SugarFootPedals/AudioScope/AudiOscope_front.JPG

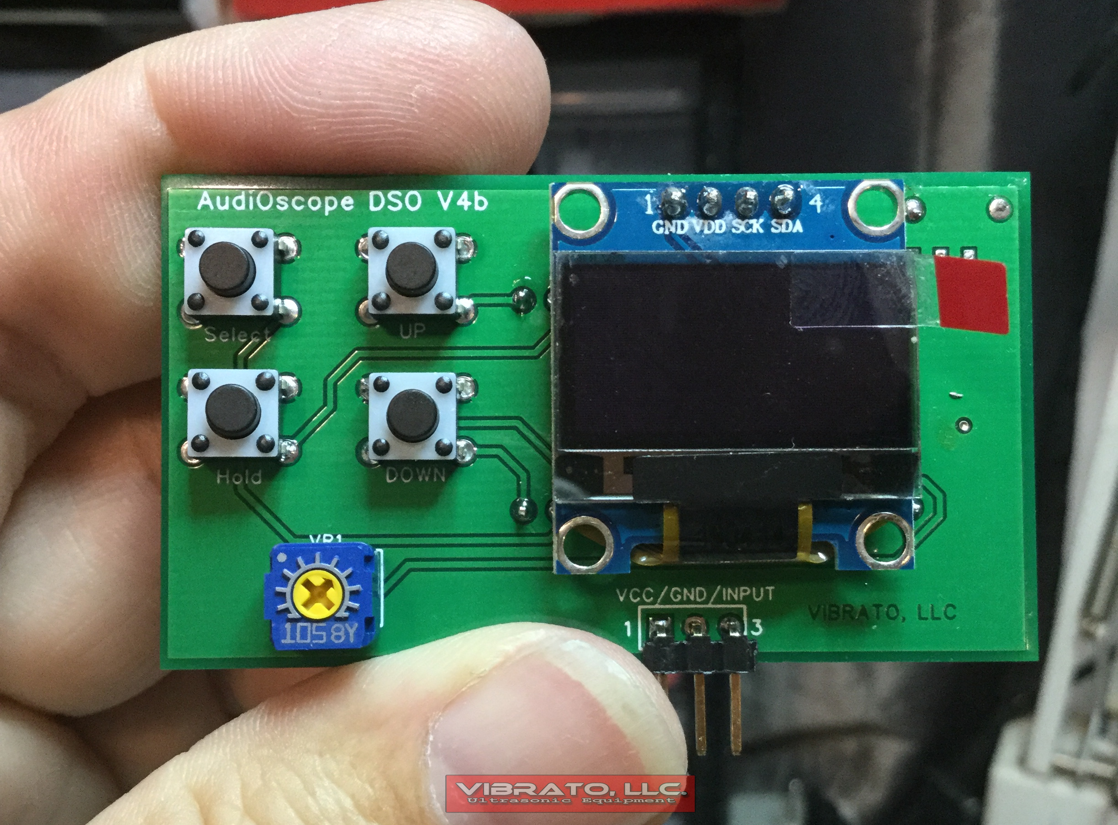
AudiOscope_front.JPG
