SugarFootPedals/AudioScope/AudiOscope Noise.JPG

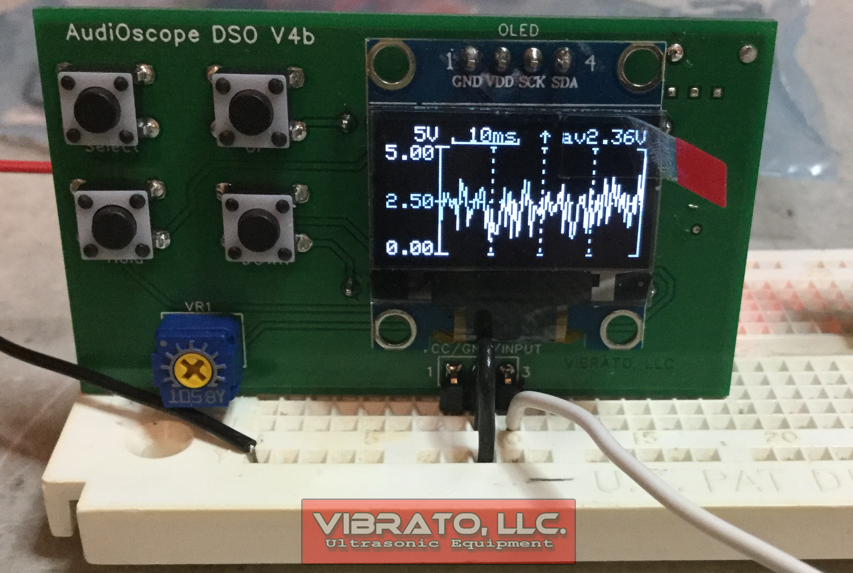
AudiOscope Noise.JPG
