SugarFootPedals/AudioScope/README.txt

A bread-boardable open-source Digital Storage Oscilloscope perfect for viewing audio signals while building sound circuits.

Based on this project by RadioPench : http://radiopench.blog96.fc2.com/blog-entry-893.html

Uses a generic Arduino-compatible ProMini and low count surface-mount devices (smd's).

Original and New Schematic, Working Arduino Code, gerber files included.
