SugarFootPedals/AudioScope/AudiOscope Boot.JPG

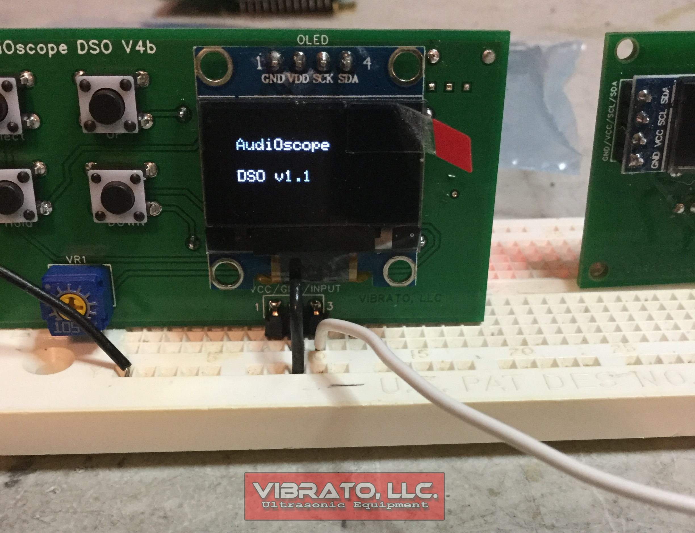
AudiOscope Boot.JPG
