SugarFootPedals/AudioScope/AudiOscope Chainsaw.JPG

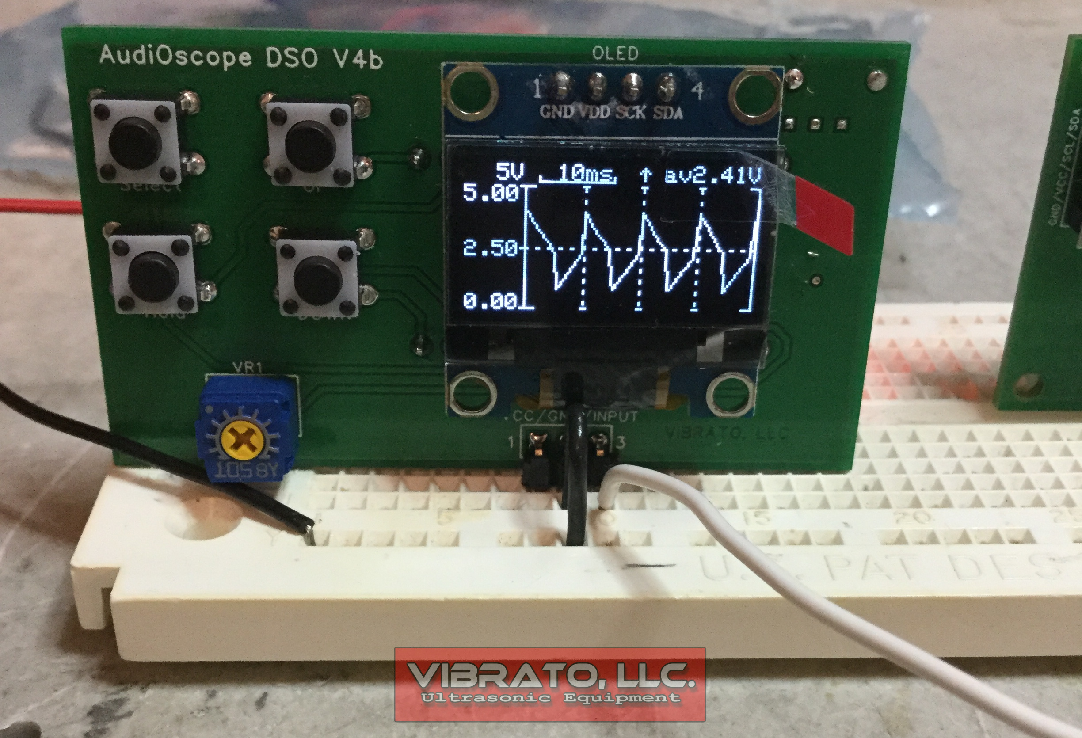
AudiOscope Chainsaw.JPG
