SugarFootPedals/AudioScope/AudiOscope DSO V4c.bmp

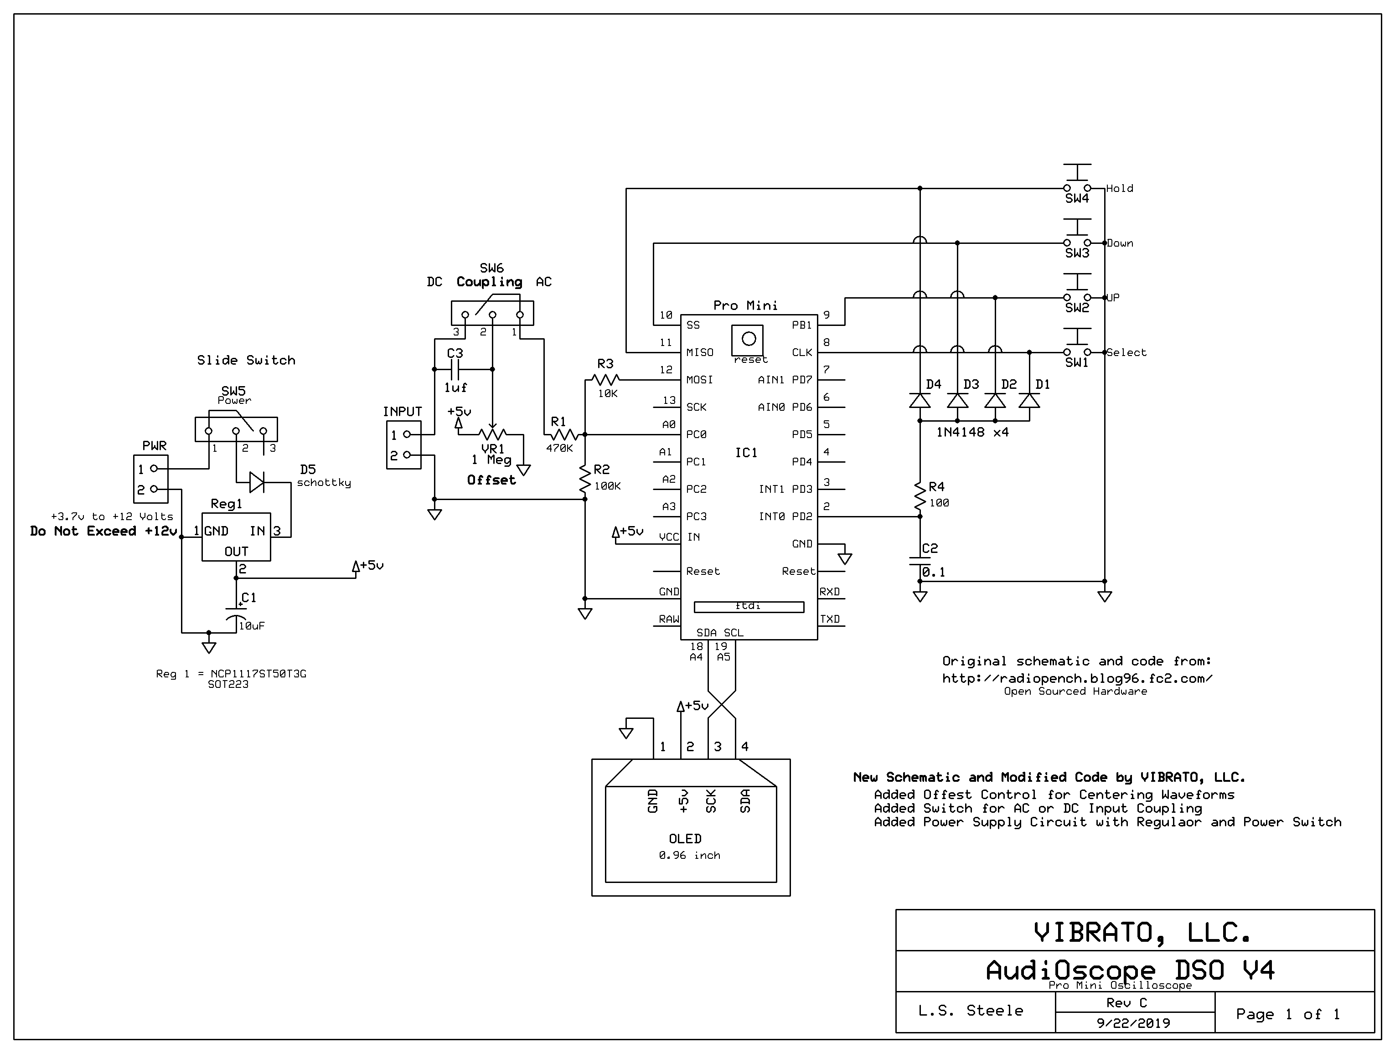
AudiOscope DSO V4c.bmp
