SugarFootPedals/AudioScope/AudiOscope Sine.JPG

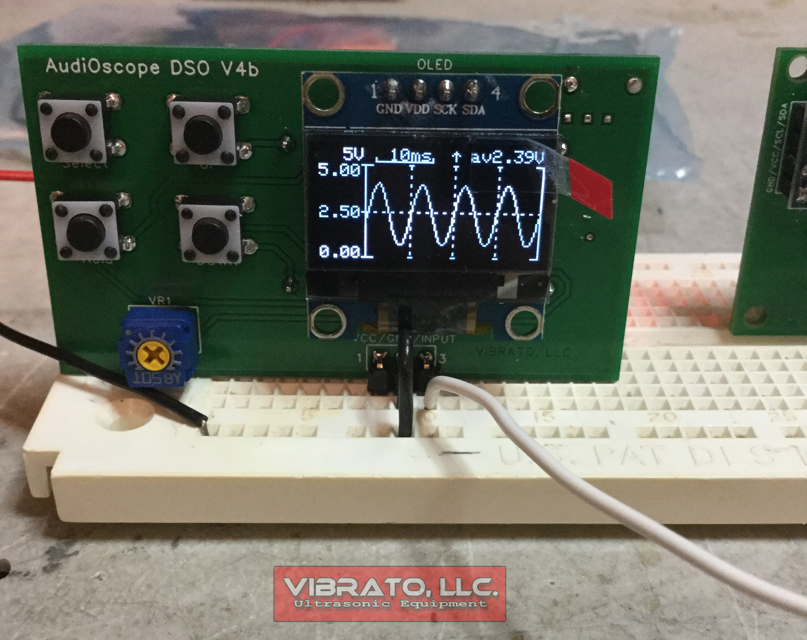
AudiOscope Sine.JPG
