SugarFootPedals/AudioScope/AudiOscope_back.JPG

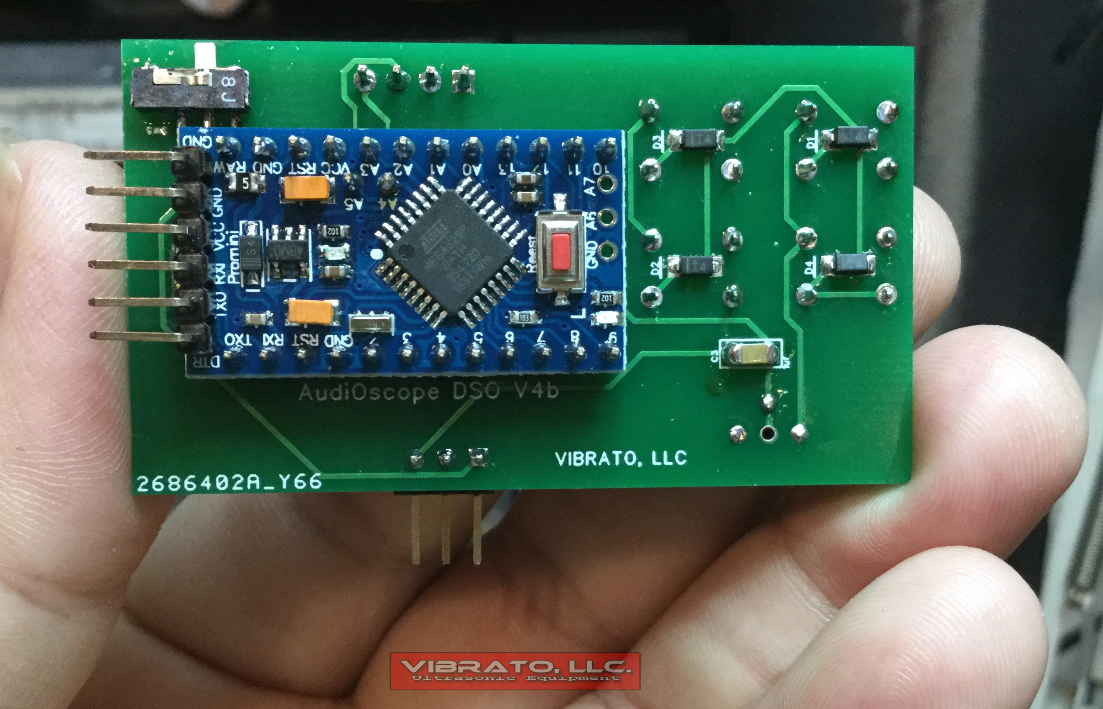
AudiOscope_back.JPG
