SugarFootPedals/AudioScope/Original DSO Schematic.png

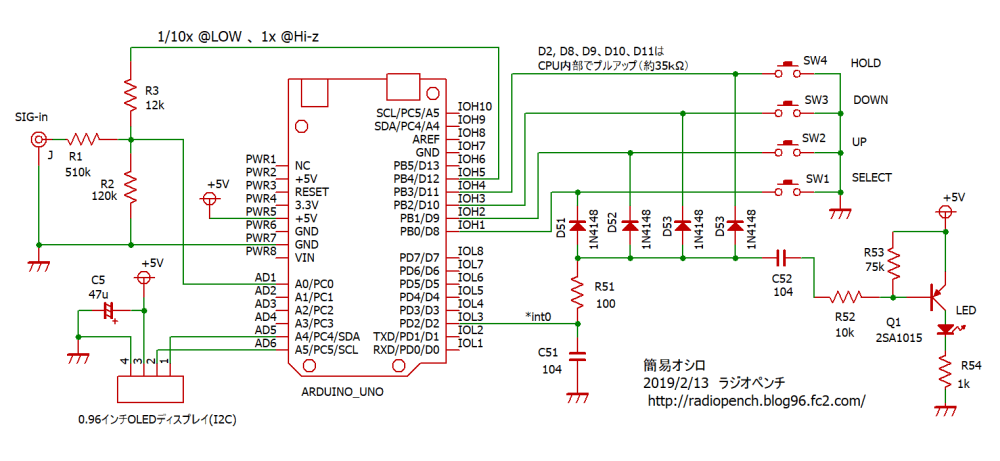
Original DSO Schematic.png
